vishnubob/dw611/README.md

# Dewalt 611 Deflector and Dust Shoe

The Dewalt 611 is a great router to use as the spindle for CNC machines, but it does have one drawback: the motor is air cooled, and this air is vented out the bottom of the motor housing.  This blows all the chips and dust into the environment, making everything a big mess.  I've designed this plate to screw into the bottom of the router, deflecting the air upwards and away from the spindle.  I've also added an optional mounting for a vacuum hose with a footprint that can accommodate a removable, magnetized dust shoe.  

You can either print just the deflector plate, or you can print the deflector plate with the vacuum coupling and the dust shoe. 

You can customize the SCAD code to tweak the model to your needs.  The SCAD is somewhat difficult to manipulate because it is generated by Python code.  In order to use the Python code, you will need to install my [SCAD module](https://github.com/vishnubob/pyscad).

## Assembly Instructions

In order to attach the deflector plate, you will will need the following items:  

* [20mm M4 Socket Cap Screws](http://www.mcmaster.com/#91292a121/=vqmvl1) (x2)  
* [M4 close ended tap](http://www.mcmaster.com/#8305a54/=vqmxbb) (x1)  

Steps:  

1. Remove the two tapping screws from the bottom of your router.  

2. Remove the yellow arrestor button and its housing from the side of the router.  

3. Using the preexisting screw holes on the button housing, carefully re-tap the holes with an M4 tap.  Ideally, you will have a closed-ended tap, but you can also get away with using a through hole tap.  Just make sure not to drive the tap too far, or else you will puncture the plastic button housing.  

4. Position the deflector plate against the base of the router, inserting the screw posts into the recessed holes on the bottom.  

5. Install the arrestor button and its housing into the router, and use two 20MM M4 socket caps screws to secure the deflector to the router base.  

If you want to use the dust shoe, follow the same instructions above.   You will need a few more things to complete the build.  

* [Neodymium Disc Magnets - 1/4" x 1/16"](http://www.amazon.com/gp/product/B00IZDJ5H8/ref=oh_aui_search_detailpage?ie=UTF8&psc=1) (x8)  
* [Epoxy](http://www.amazon.com/J-B-Weld-8265S-Original-Reinforced/dp/B0006O1ICE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) (x1)  
* [Strip Brush or Foam](http://www.mcmaster.com/#strip-brushes/=vrhyrc)  (x1)  

Steps:  

1. The channel in the dust shoe is 7.5mm wide.  If you need the channel wider, you will need to edit the Python or SCAD code to your specifications.  You can also adjust the diameter and depth of your magnets.  

2. Once you print the deflector mount and dust shoe, apply glue into the eight magnet holes and insert your magnets.  Make sure you attach the magnets with opposing poles (for example, all North facing magnets in the deflector mount, and all South facing magnets in your dust shoe).  Let the glue cure.  

3. Slowly glue in your brush strip, adding glue as you insert the brush.  Let the glue cure.
