vishnubob/dw611/objects/dw611_deflector.stl

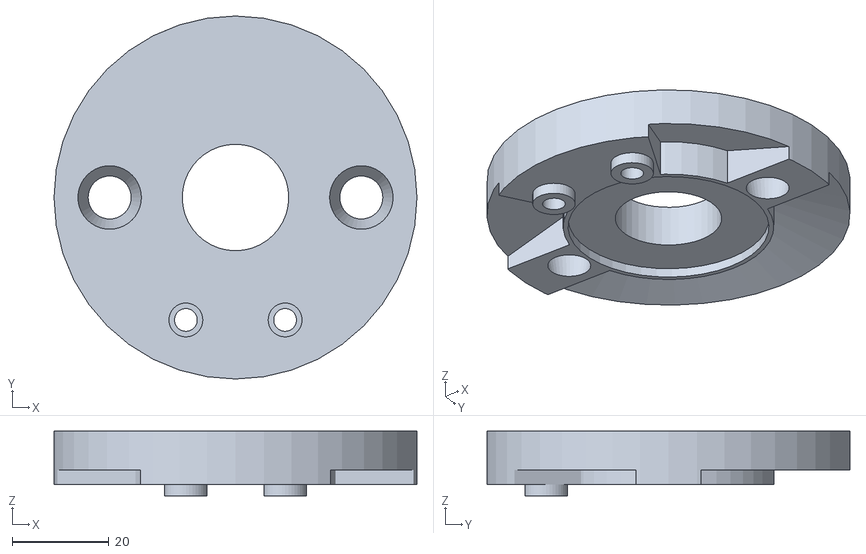
[picture p1: CAD file, 2015-02-04]
objects/dw611_deflector.stl
75.0 x 75.0 x 13.4
