vishnubob/dw611/objects/dustshoe.stl

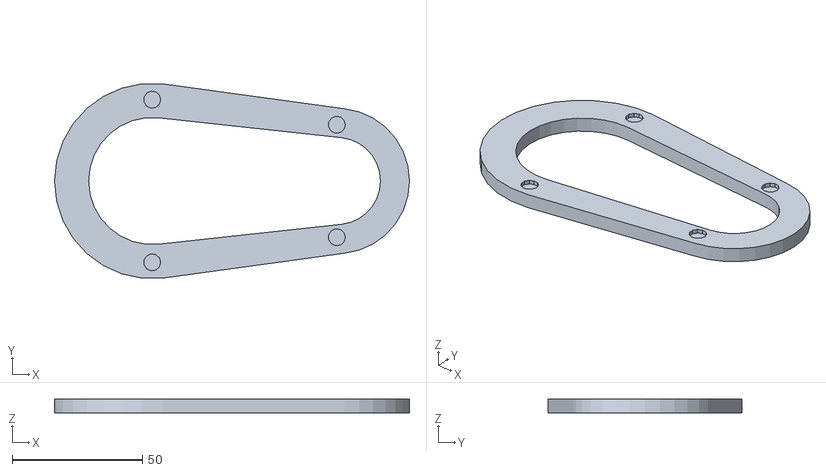
[picture p2: CAD file, 2015-02-04]
objects/dustshoe.stl
136.2 x 74.6 x 5.50
