vishnubob/dw611/objects/dw611_deflector_vacuum.stl

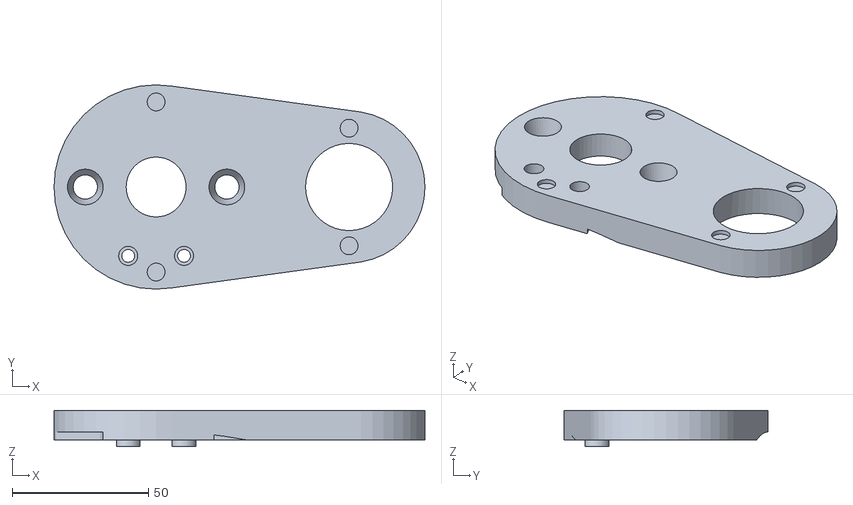
[picture p3: CAD file, 2015-02-04]
objects/dw611_deflector_vacuum.stl
136.2 x 75.0 x 13.4
