vishnubob/dw611/(list of files, cad)

Other CAD files:
objects/dw611_deflector_vacuum.scad
